jrowe88/RPi-LED-RGBMatrix-Hat/documentation/schematic.pdf

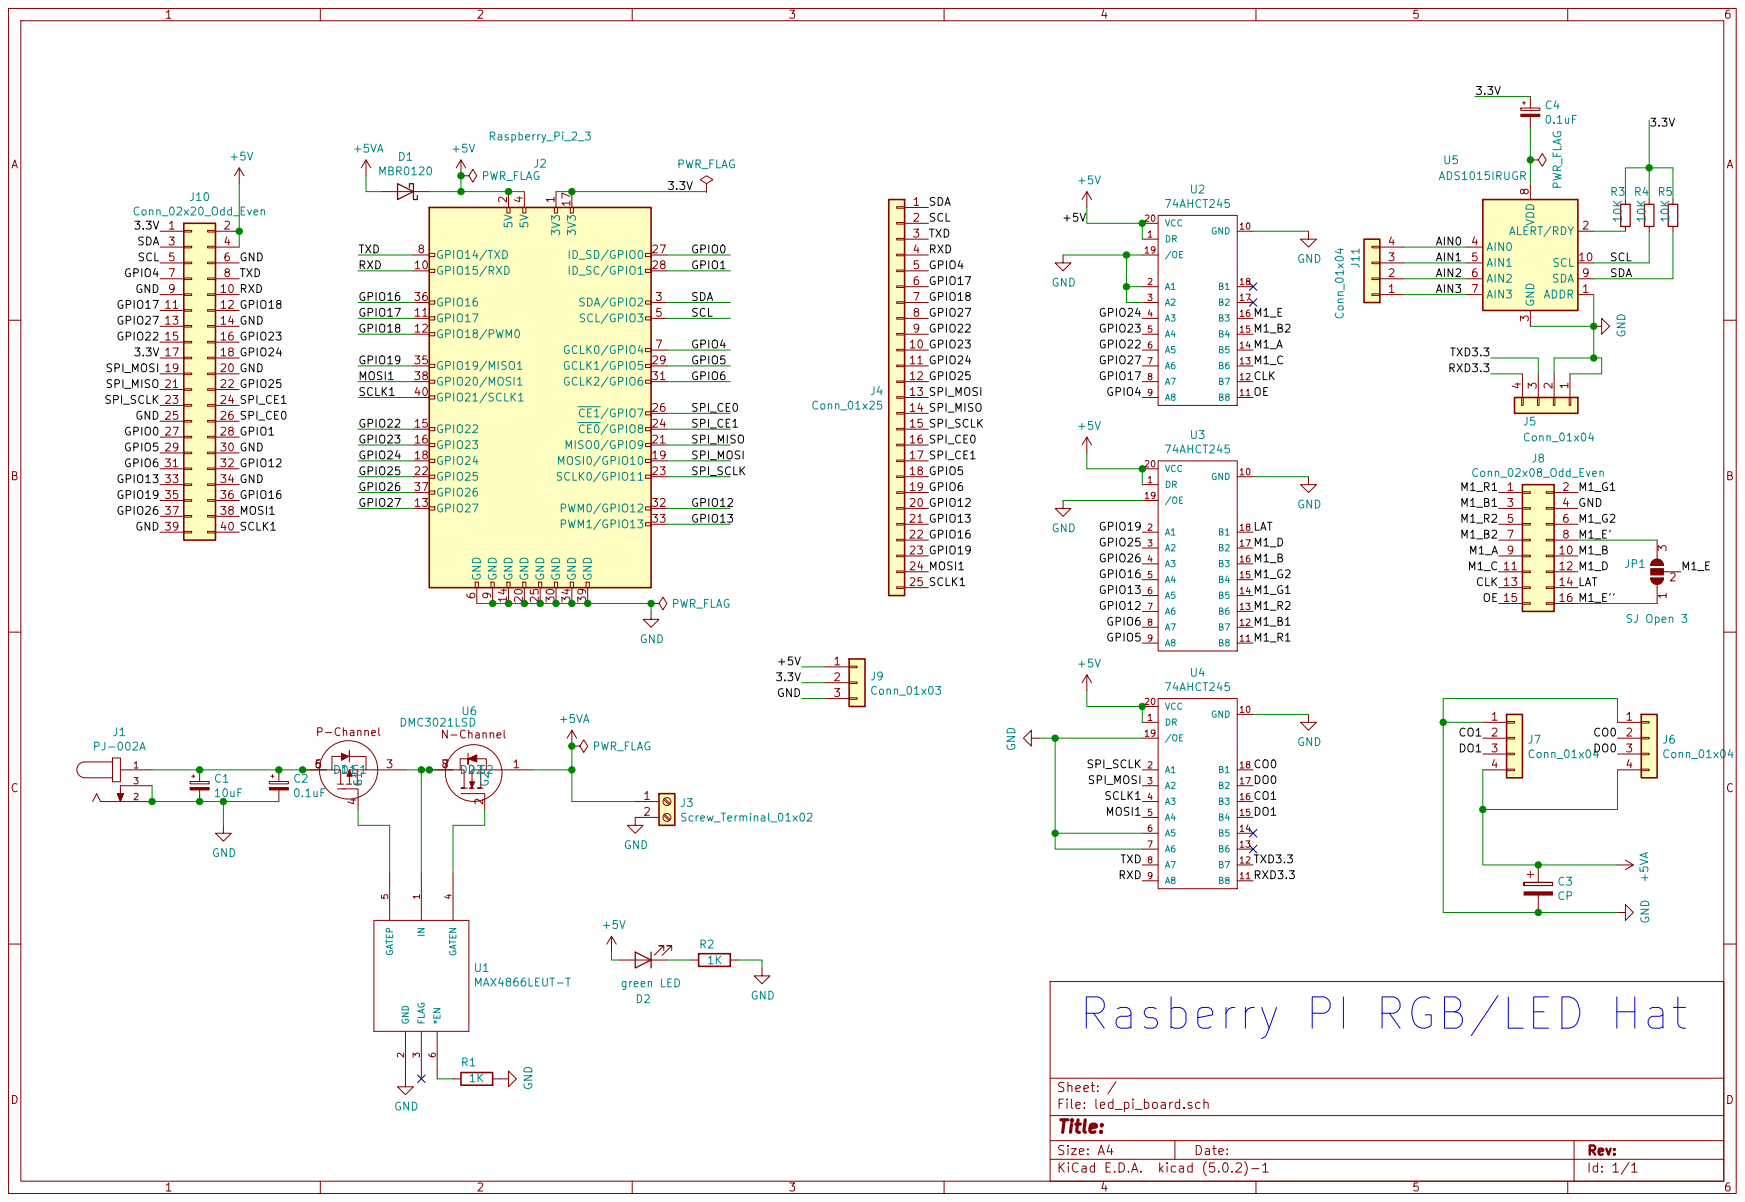
[picture p5: page 1]
