jrowe88/RPi-LED-RGBMatrix-Hat/led_pi_board.kicad_pcb

## KiCad design led_pi_board.kicad_pcb (2019-03-21)

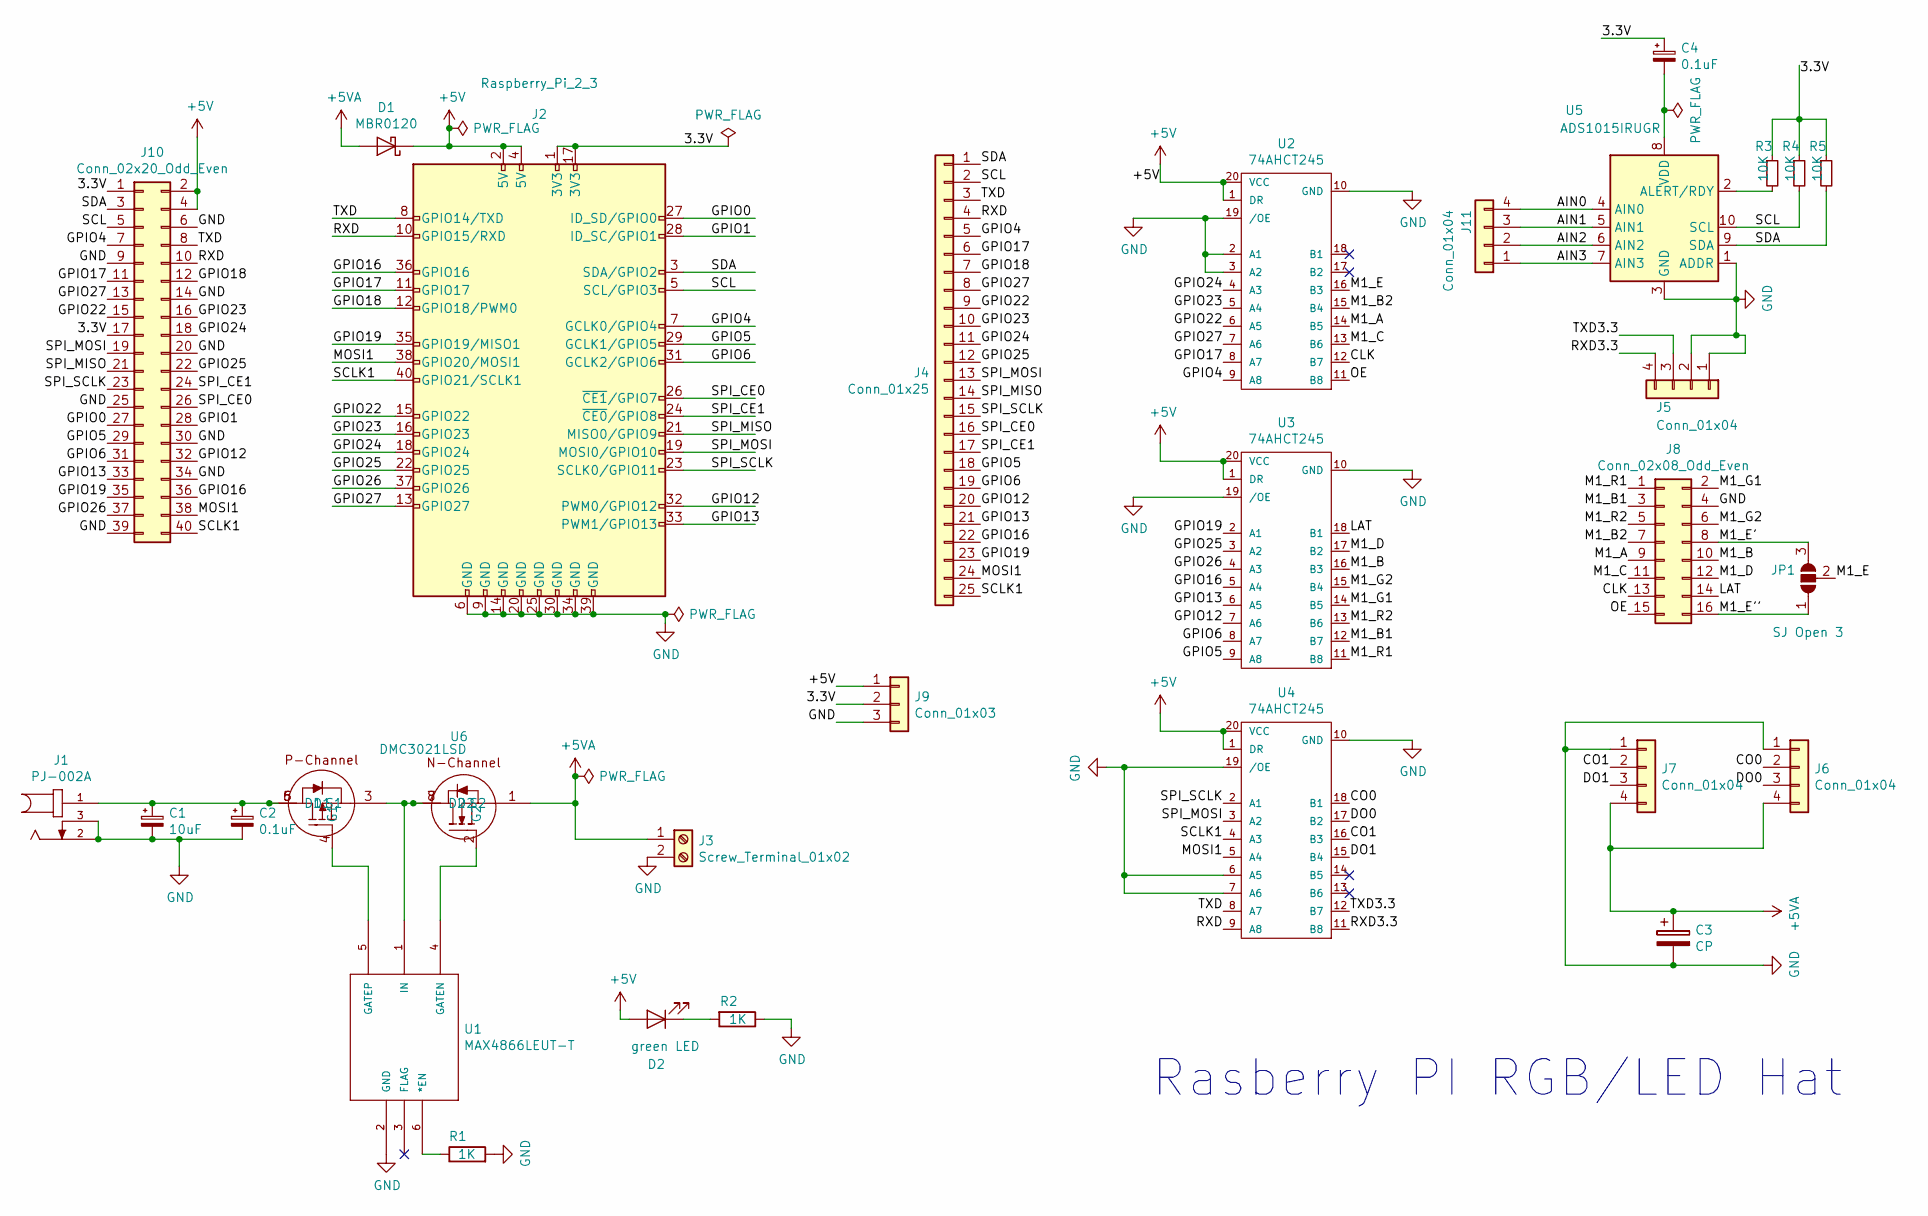
[picture p6: schematic led_pi_board.sch]

Parts:
C1: 10uF; C_0805_2012Metric
C2, C4: 0.1uF; C_0603_1608Metric
C3: CP; 2917 Cap
D1: MBR0120; D_SOD-123
D2: green LED; LED_0603_1608Metric
J1: PJ-002A; CUI_PJ-002A
J2: Raspberry_Pi_2_3; PinHeader_2x20_P2.54mm_Vertical
J3: Screw_Terminal_01x02; TerminalBlock_bornier-2_P5.08mm
J4: Conn_01x25; PinHeader_1x25_P2.54mm_Vertical
J5, J11: Conn_01x04; PinHeader_1x04_P2.54mm_Vertical
J6, J7: Conn_01x04; PinSocket_1x04_P2.54mm_Vertical
J8: Conn_02x08_Odd_Even; PinSocket_2x08_P2.54mm_Vertical
J9: Conn_01x03; PinHeader_1x03_P2.54mm_Vertical
J10: Conn_02x20_Odd_Even; PinHeader_2x20_P2.54mm_Vertical_SMD
JP1: SJ Open 3; SolderJumper-3_P1.3mm_Open_RoundedPad1.0x1.5mm
R1, R2: 1K; R_0603_1608Metric
R3, R4, R5: 10K; R_0603_1608Metric
U1: MAX4866LEUT-T; TSOT-23-6
U2, U3, U4: 74AHCT245; SOP65P640X110-20N
U5: ADS1015IRUGR; SOP50P490X110-10N
U6: DMC3021LSD; SO-8

Connections:
+5V: D1.1 (K), D2.2 (A), J2.2 (5V), J2.4 (5V), J9.1, J10.2, J10.4, U2.1 (DR), U2.20 (VCC), U3.1 (DR), U3.20 (VCC), U4.1 (DR), U4.20 (VCC)
+5VA: C3.1, D1.2 (A), J3.1, J6.4, J7.4, U6.1 (S2)
/3.3V: C4.1, J2.1 (3V3), J2.17 (3V3), J9.2, J10.1, J10.17, R3.1, R4.1, R5.1
/AIN0: J11.4, U5.4 (AIN0)
/AIN1: J11.3, U5.5 (AIN1)
/AIN2: J11.2, U5.6 (AIN2)
/AIN3: J11.1, U5.7 (AIN3)
/CLK: J8.13, U2.12 (B7)
/CO0: J6.2, U4.18 (B1)
/CO1: J7.2, U4.16 (B3)
/DO0: J6.3, U4.17 (B2)
/DO1: J7.3, U4.15 (B4)
/GPIO0: J2.27 (ID_SD/GPIO0), J10.27
/GPIO1: J2.28 (ID_SC/GPIO1), J10.28
/GPIO4: J2.7 (GCLK0/GPIO4), J4.5, J10.7, U2.9 (A8)
/GPIO5: J2.29 (GCLK1/GPIO5), J4.18, J10.29, U3.9 (A8)
/GPIO6: J2.31 (GCLK2/GPIO6), J4.19, J10.31, U3.8 (A7)
/GPIO12: J2.32 (PWM0/GPIO12), J4.20, J10.32, U3.7 (A6)
/GPIO13: J2.33 (PWM1/GPIO13), J4.21, J10.33, U3.6 (A5)
/GPIO16: J2.36 (GPIO16), J4.22, J10.36, U3.5 (A4)
/GPIO17: J2.11 (GPIO17), J4.6, J10.11, U2.8 (A7)
/GPIO18: J2.12 (GPIO18/PWM0), J4.7, J10.12
/GPIO19: J2.35 (GPIO19/MISO1), J4.23, J10.35, U3.2 (A1)
/GPIO22: J2.15 (GPIO22), J4.9, J10.15, U2.6 (A5)
/GPIO23: J2.16 (GPIO23), J4.10, J10.16, U2.5 (A4)
/GPIO24: J2.18 (GPIO24), J4.11, J10.18, U2.4 (A3)
/GPIO25: J2.22 (GPIO25), J4.12, J10.22, U3.3 (A2)
/GPIO26: J2.37 (GPIO26), J10.37, U3.4 (A3)
/GPIO27: J2.13 (GPIO27), J4.8, J10.13, U2.7 (A6)
/LAT: J8.14, U3.18 (B1)
/M1_A: J8.9, U2.14 (B5)
/M1_B: J8.10, U3.16 (B3)
/M1_B1: J8.3, U3.12 (B7)
/M1_B2: J8.7, U2.15 (B4)
/M1_C: J8.11, U2.13 (B6)
/M1_D: J8.12, U3.17 (B2)
/M1_E: JP1.2 (C), U2.16 (B3)
/M1_E': J8.8, JP1.3 (B)
/M1_E'': J8.16, JP1.1 (A)
/M1_G1: J8.2, U3.14 (B5)
/M1_G2: J8.6, U3.15 (B4)
/M1_R1: J8.1, U3.11 (B8)
/M1_R2: J8.5, U3.13 (B6)
/MOSI1: J2.38 (GPIO20/MOSI1), J4.24, J10.38, U4.5 (A4)
/OE: J8.15, U2.11 (B8)
/RXD: J2.10 (GPIO15/RXD), J4.4, J10.10, U4.9 (A8)
/RXD3.3: J5.4, U4.11 (B8)
/SCL: J2.5 (SCL/GPIO3), J4.2, J10.5, R4.2, U5.10 (SCL)
/SCLK1: J2.40 (GPIO21/SCLK1), J4.25, J10.40, U4.4 (A3)
/SDA: J2.3 (SDA/GPIO2), J4.1, J10.3, R5.2, U5.9 (SDA)
/SPI_CE0: J2.26 (~CE1~/GPIO7), J4.16, J10.26
/SPI_CE1: J2.24 (~CE0~/GPIO8), J4.17, J10.24
/SPI_MISO: J2.21 (MISO0/GPIO9), J4.14, J10.21
/SPI_MOSI: J2.19 (MOSI0/GPIO10), J4.13, J10.19, U4.3 (A2)
/SPI_SCLK: J2.23 (SCLK0/GPIO11), J4.15, J10.23, U4.2 (A1)
/TXD: J2.8 (GPIO14/TXD), J4.3, J10.8, U4.8 (A7)
/TXD3.3: J5.3, U4.12 (B7)
GND: C1.2, C2.2, C3.2, J1.2, J1.3, J2.6 (GND), J2.9 (GND), J2.14 (GND), J2.20 (GND), J2.25 (GND), J2.30 (GND), J2.34 (GND), J2.39 (GND), J3.2, J5.1, J5.2, J6.1, J7.1, J8.4, J9.3, J10.6, J10.9, J10.14, J10.20, J10.25, J10.30, J10.34, J10.39, R1.2, R2.1, U1.2 (GND), U2.2 (A1), U2.3 (A2), U2.10 (GND), U2.19 (/OE), U3.10 (GND), U3.19 (/OE), U4.6 (A5), U4.7 (A6), U4.10 (GND), U4.19 (/OE), U5.1 (ADDR), U5.3 (GND)
unnamed: C1.1, C2.1, J1.1, U6.5 (D1), U6.6 (D1)
unnamed: C4.2, U5.8 (VDD)
unnamed: D2.1 (K), R2.2
unnamed: R1.1, U1.6 (*EN)
unnamed: R3.2, U5.2 (ALERT/RDY)
unnamed: U1.1 (IN), U6.3 (S1), U6.7 (D2), U6.8 (D2)
unnamed: U1.4 (GATEN), U6.2 (G2)
unnamed: U1.5 (GATEP), U6.4 (G1)

Notes on the sheet:
Rasberry PI RGB/LED Hat

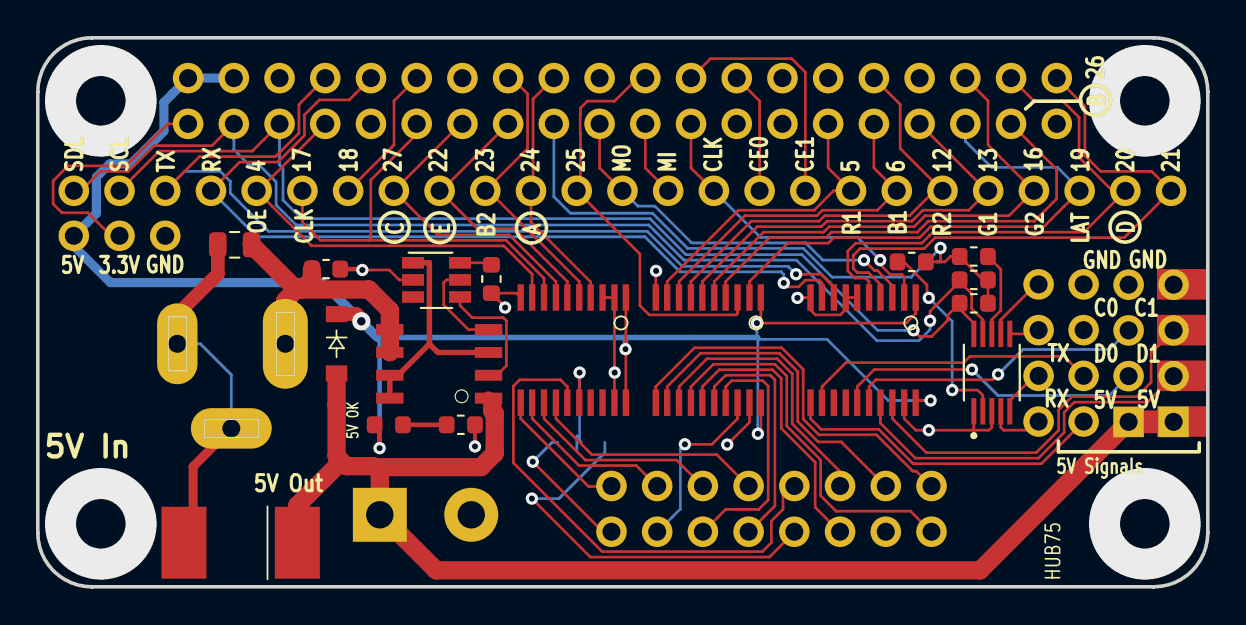
[picture p7: board led_pi_board.kicad_pcb from above]

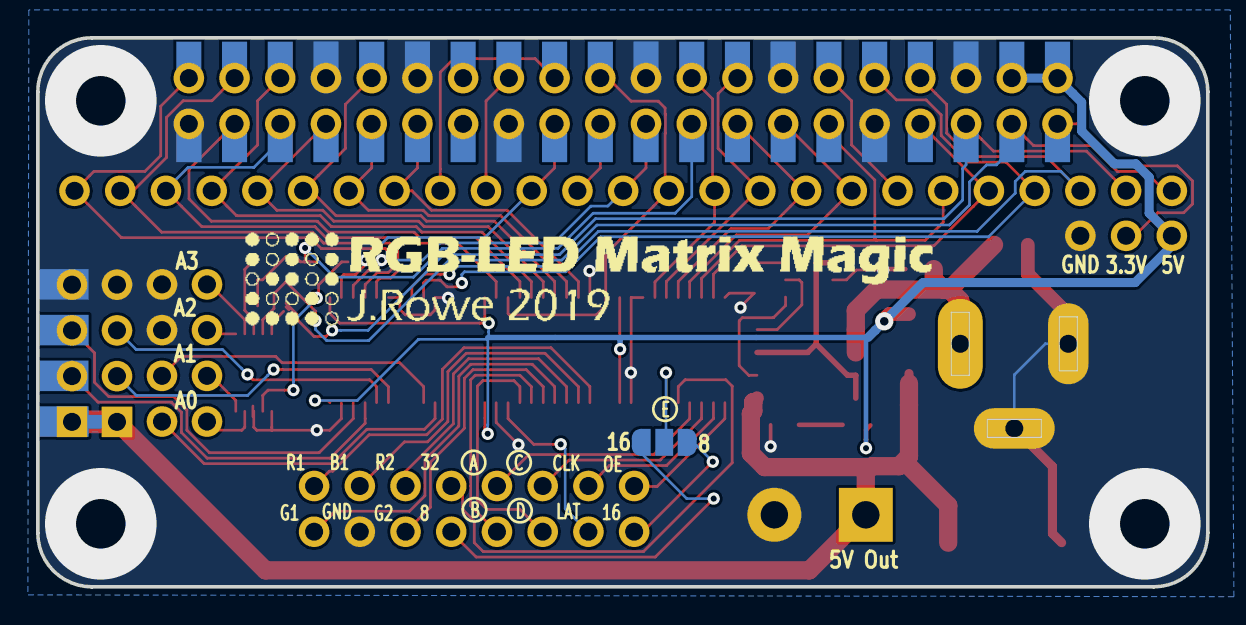
[picture p8: board led_pi_board.kicad_pcb from below]

Board: 2 copper layers, 65.0 x 30.5 mm, 30 parts (3 on the bottom side), 66 nets.

Other parts of the board:
LOGO: LOGO
