jrowe88/RPi-LED-RGBMatrix-Hat/(commit log)

2019-03-12 updates to v5
    [led_pi_board.kicad_pcb, led_pi_board.sch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]
2019-03-21 version 5 updates
    [led_pi_board.kicad_pcb]
